kuaner/esp32-p4-7b-enclosure/docs/DEVELOPMENT.md

# 开发与复现

## 最小构建

使用 Python 3.12 和虚拟环境，依赖见 `cad/requirements.txt`。仓库已包含可直接使用的 STL、STEP、预览和报告。

```sh
python3.12 -m venv .venv
source .venv/bin/activate
python -m pip install -r cad/requirements.txt
python cad/check_release.py
python cad/build_design.py
python cad/check_printability.py
```

`check_release.py` 仅依赖标准库，验证发布清单和证据，适合首次构建前运行。构建会覆盖相应导出；STEP 元数据时间可能变化，需重跑必要检查后刷新文件清单。

Windows 使用 `.venv\Scripts\activate`。Linux 可能需要 `libgl1 libegl1 libopengl0`；离屏渲染还依赖可用的 VTK/OpenGL 后端。CI 执行模型构建与逐层检查，不运行依赖原厂文件的装配检查或 macOS Bambu 切片。

## 原厂配合检查

从 [Waveshare 原厂资源入口](https://docs.waveshare.com/ESP32-P4-WIFI6-Touch-LCD-7B/Resources-And-Documents) 获取 `ESP32-P4-WIFI6-Touch-LCD-7B_3d-20251108.stp`，放入根目录。SHA-256：

```text
f2104dc257ee8575459ddf74404e32faf81e4bcda23a8bfec23b6604c089986c
```

原厂附件可能更新；无法获取此日期文件时请联系厂商。不要直接替换成其他文件：当前坐标和元件检查依赖此文件的组件编号。脚本校验原文件哈希，不改写原件。

```sh
python cad/analyze_board.py
python cad/verify_design.py
```

也可用 `python cad/analyze_board.py /path/to/reference.stp` 指定相同文件。缓存位于 `design/reference/`，不进入 Git 或发布包。`fit_reference.py` 只应用整体坐标平移，完整保留玻璃、LCD、PCB、元件及两根 FPC，不再局部排除排线。`screen_geometry.py` 按 STEP 的两级玻璃轮廓定义前口，并在原排线位置定义两个局部避让；真实排线应力和任意折叠形状仍未仿真。

当前实物反馈已确认屏幕尺寸合适，长短边及台阶配合尺寸保持不动。触摸和 LCD 缺口都必须开到屏幕面；LCD 原有斜顶虽能避开原厂静态排线，却阻挡真实装入，因此禁止恢复该斜顶。`verify_design.py` 使用独立的前端通路包络检查这两个入口，不能只检查最终装配位置。不能只修改玻璃外包尺寸而忽略其 0.25 mm 前沿与后部的不同轮廓。挂钩需检查四组真实接头的双向轴向自由行程，不能仅以远距离拉脱阻挡作为松紧判据。板端插头本体不在原厂模型中，`wire_route.py` 中的 10 × 6.5 × 5.5 mm 插头包络属于待实测预留值；PH 参考外形来源见打印说明，不能当作用户插头的实测值。凹位距内壁必须保留 1.5 mm 实心边。

## 逐层几何与切片

`check_printability.py` 以 0.20 mm 水平截面分析上一层承托、孤岛和两端承托短桥，目标为喇叭盒与底座。主壳侧面接口和顶部相机口仍包含桥接。

可选参考切片使用 macOS Bambu Studio 02.08.02.61 内置 P1S 0.4 mm 和 Generic PETG 配置：

```sh
python cad/check_slice.py
```

默认应用 `/Applications/BambuStudio.app`，可用 `BAMBU_APP` 指定其他 `.app` 路径。脚本使用临时配置、关闭支撑、保持交付方向，记录真实输入哈希、支撑刀路和警告，不修改用户设置。其他应用版本、平台和配置布局尚未适配，不要手改版本字段伪造复现。

## 渲染

先完成模型构建与原厂缓存分析，再运行 `python cad/render_design.py`。脚本尝试寻找系统中文字体；也可用 `CAD_CJK_FONT` 指定 `.ttf` / `.ttc`，例如 Linux 安装 Noto CJK 后：

```sh
CAD_CJK_FONT=/usr/share/fonts/opentype/noto/NotoSansCJK-Regular.ttc python cad/render_design.py
```

预览直接渲染实际 BREP。正式图片包括整体、正面、背面、分解、底座、挂槽遮挡、打印方向和配合细节八张。安装图解另用 `python cad/render_assembly.py` 生成三张 `assembly_speaker.png`、`assembly_screen.png`、`assembly_mounts.png`，使用同一坐标及已有装配变换，标注接线、斜放屏幕、四颗螺丝和上下排不同挂接方向。喇叭没有独立原厂 3D 模型，图中用明确标注的尺寸占位表示，不将其当作真实振膜或框架模型。

其余裁切和 `assembly_detail_*.png` 为本地中间文件，不进入正式清单。面向 MakerWorld 的图文说明位于 [MAKERWORLD.md](MAKERWORLD.md)，配图使用相对路径，三张安装图可单独上传。

## 发布流程

模型变更后完成相应检查和渲染，本地只刷新发布清单，不创建 ZIP：

```sh
python cad/prepare_release.py --manifest-only
python cad/check_release.py
```

提交并推送源码、导出和检查报告后，打 tag 并推送即可：

```sh
git tag 20261021
git push origin 20261021
```

标签名自行选择，不要求日期或固定前缀。Release 标题直接使用 tag 名。也可在 Actions 中手动运行 **Release models**，填写已有 tag 重新构建发布。

CI 先验证提交的文件和证据，再从该 tag 重建 CAD 并做逐层检查。不同平台的 Open CASCADE 可能产生不同三角划分，因此 `check_rebuild.py` 直接对照提交中的五个 STEP，要求实体数相同、包围边界偏差不超过 0.000001 mm，双向布尔差和体积差均不超过 0.0001 mm³。发布的 STL 保留已实际切片的原始字节和哈希；STEP 使用本次重建结果，不将云端的新 STL 冒充为已经切片的输入。发布任务直接上传：

- `shell.stl` / `shell.step`：主壳。
- `speaker.stl` / `speaker.step`：喇叭盒。
- `stand.stl` / `stand.step`：底座。
- `assembly.step`：装配。
- `expansion_adapter.step`：扩展接口模板。
- `SHA256SUMS.txt`：以上八个文件的校验值。

不生成额外 ZIP。源码使用 GitHub 自带的 Source code 下载入口。STEP 由该次构建生成，元数据时间可能变化，校验值按实际发布文件计算。仓库文件清单仍用于核对已提交的源码、模型和检查证据。

几何改动后必须重新生成对应证据。CI 不下载原厂文件，也不假称在 Linux 复跑了完整板卡检查或 macOS Bambu 切片。普通构建只读取仓库；上传 Release 的任务拥有仓库内容写入权限。

## 坐标与接口

单位 mm，装配 +Y 向上、+Z 向背后；主壳背面 Z=22、模块贴合面 Z=22.2，前玻璃约为 Z=0。STL 经变换后贴床，STEP 保留装配位置。

挂点 X=±62.5，上排 Y=20，下排 Y=−28。上下排方向相反，分别让上挂模块和下托底座由重力落座。`interface.py` 的 `flat_adapter()` 为设计模板，不是额外必打印件；新附件应单独验证承载与安装运动。
