kuaner/esp32-p4-7b-enclosure/output/current/previews/rear.png

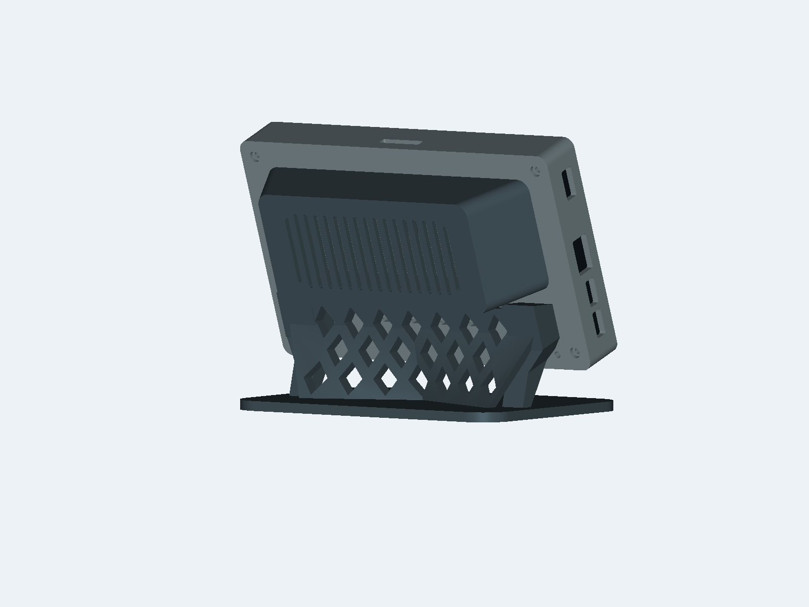
output/current/previews/rear.png
