kuaner/esp32-p4-7b-enclosure/output/current/previews/stand.png

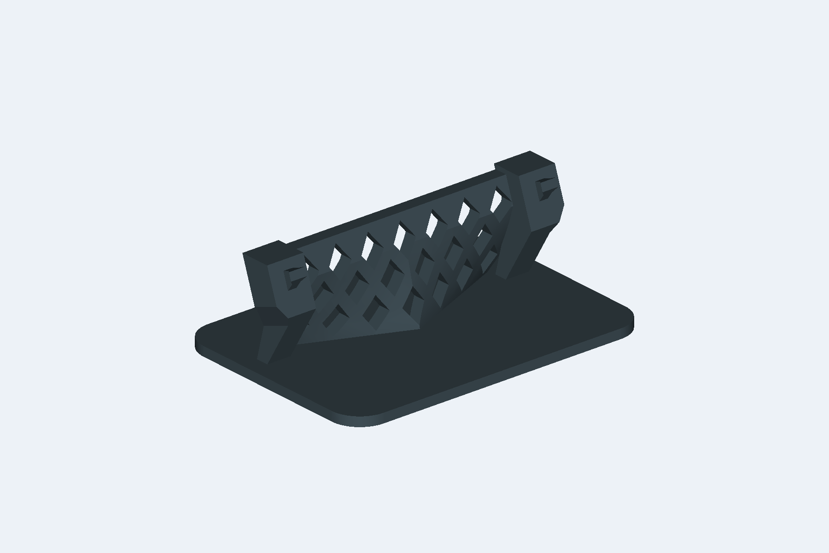
output/current/previews/stand.png
