kuaner/esp32-p4-7b-enclosure/output/current/STEP/assembly.step

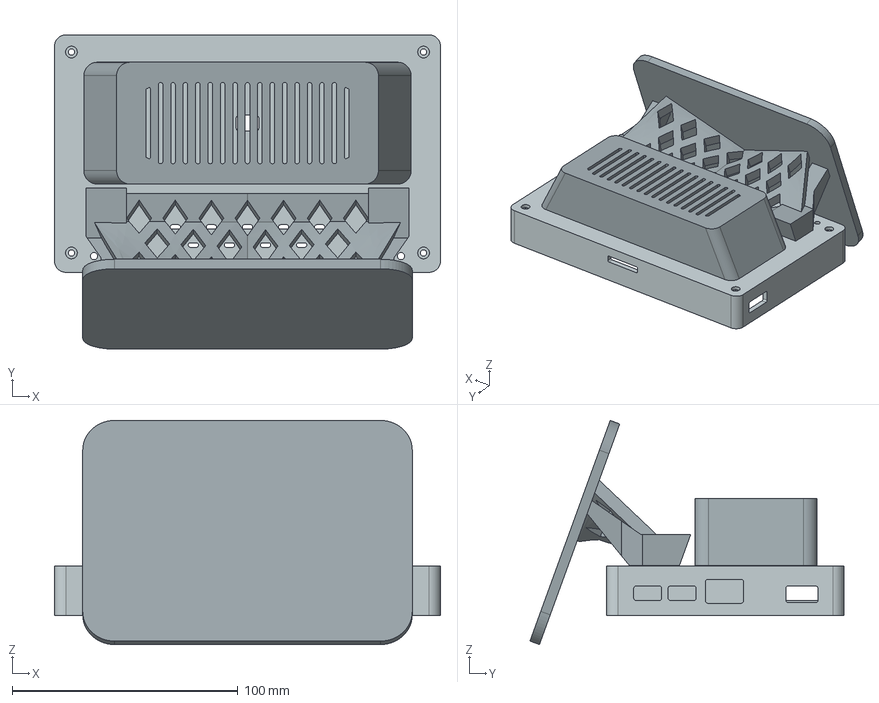
[picture p11: CAD file, 2026-10-21]
output/current/STEP/assembly.step
171.0 x 139.2 x 99.3 mm
speaker
stand
