kuaner/esp32-p4-7b-enclosure/output/current/STEP/stand.step

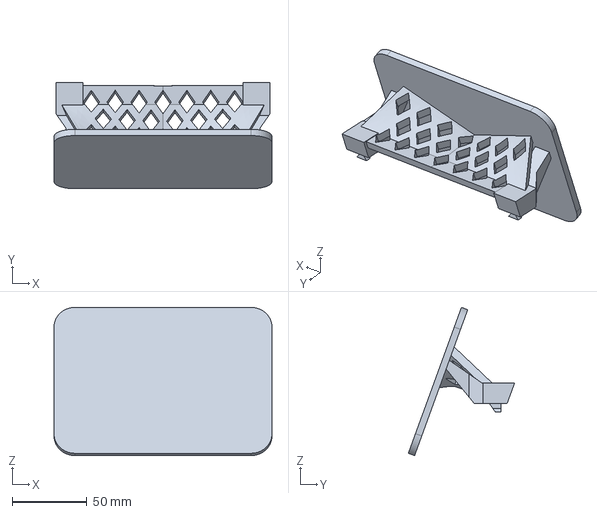
[picture p12: CAD file, 2026-10-21]
output/current/STEP/stand.step
146.0 x 71.3 x 99.3 mm
