kuaner/esp32-p4-7b-enclosure/output/current/STEP/shell.step

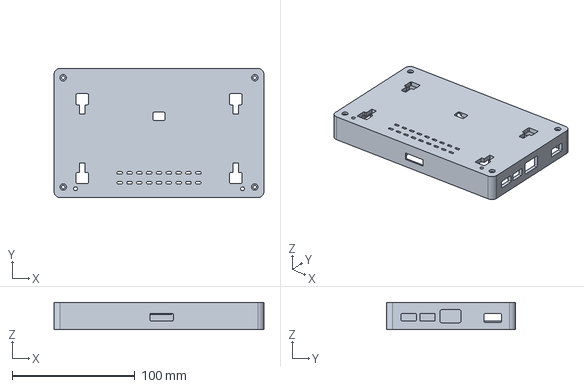
[picture p13: CAD file, 2026-10-21]
output/current/STEP/shell.step
171.0 x 105.2 x 22.0 mm
