kuaner/esp32-p4-7b-enclosure/output/current/STEP/speaker.step

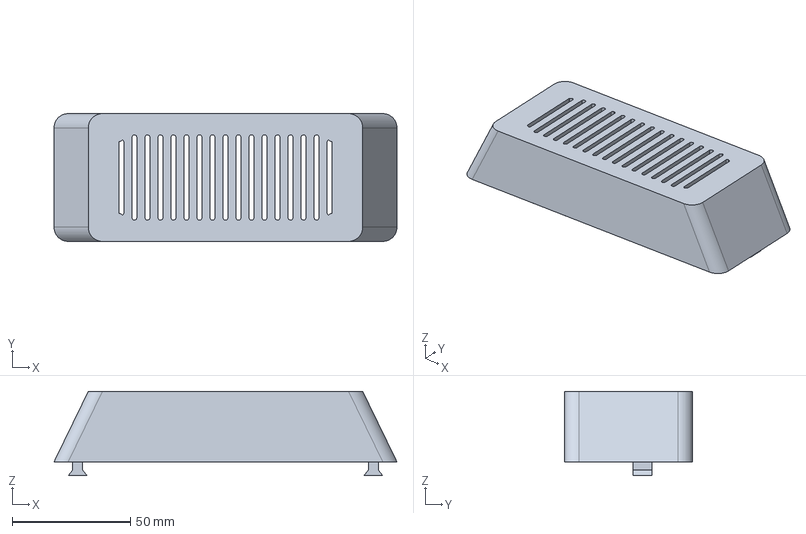
[picture p14: CAD file, 2026-10-21]
output/current/STEP/speaker.step
145.0 x 54.0 x 35.7 mm
