kuaner/esp32-p4-7b-enclosure/output/current/STEP/expansion_adapter.step

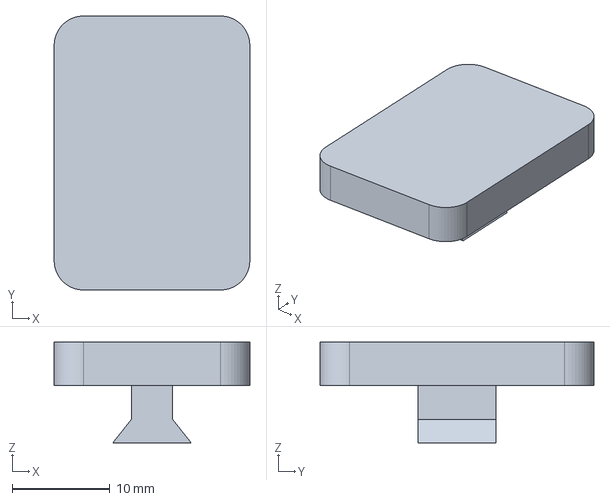
[picture p15: CAD file, 2026-10-21]
output/current/STEP/expansion_adapter.step
20.0 x 28.0 x 10.3 mm
