kuaner/esp32-p4-7b-enclosure/(list of files, cad)

Other CAD files:
output/current/STL/shell.stl
output/current/STL/speaker.stl
output/current/STL/stand.stl
