kuaner/esp32-p4-7b-enclosure/(commit log)

2026-10-20 Open source modular ESP32-P4 7B enclosure with automated model releases
    [01_DLC_shell.step, 01_DLC_shell.stl, 02_DLC_speaker.step, 02_DLC_speaker.stl, 03_stand.step, 03_stand.stl, DLC20_adapter_tile.step, assembly.step]
2026-10-20 Use current pinned GitHub Actions runtimes
2026-10-21 Fix prototype glass fit, retain FPC reliefs and tighten gravity hooks
    [01_DLC_shell.step, 01_DLC_shell.stl, 02_DLC_speaker.step, 02_DLC_speaker.stl, 03_stand.step, 03_stand.stl, DLC20_adapter_tile.step, assembly.step]
2026-10-21 Publish plainly named models from tags and keep plug recess inside the wall
    [01_DLC_shell.step, 01_DLC_shell.stl, 02_DLC_speaker.step, 03_stand.step, DLC20_adapter_tile.step, assembly.step, expansion_adapter.step, shell.step]
2026-10-21 Verify CAD solid equivalence across build platforms
2026-10-21 Inset speaker plug recess and leave a 1.5 mm solid land at the wall
    [assembly.step, expansion_adapter.step, shell.step, shell.stl, speaker.step, stand.step]
2026-10-21 Open LCD ribbon entry and add illustrated assembly guide
    [assembly.step, expansion_adapter.step, shell.step, shell.stl, speaker.step, stand.step]
